YangD5014/PETA-CUSTOM/docs/img/kicad-render-node.png

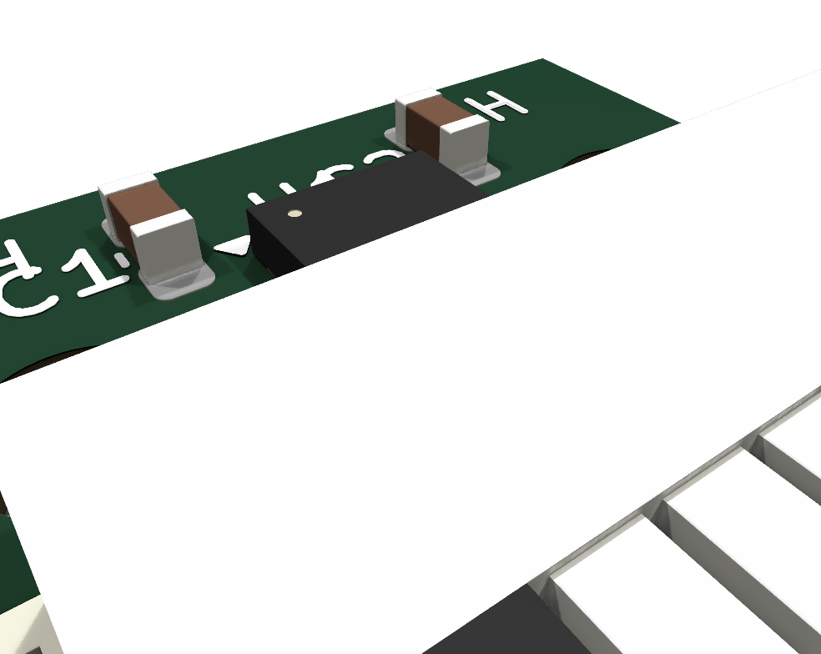
docs/img/kicad-render-node.png
