YangD5014/PETA-CUSTOM/docs/img/routed-board.png

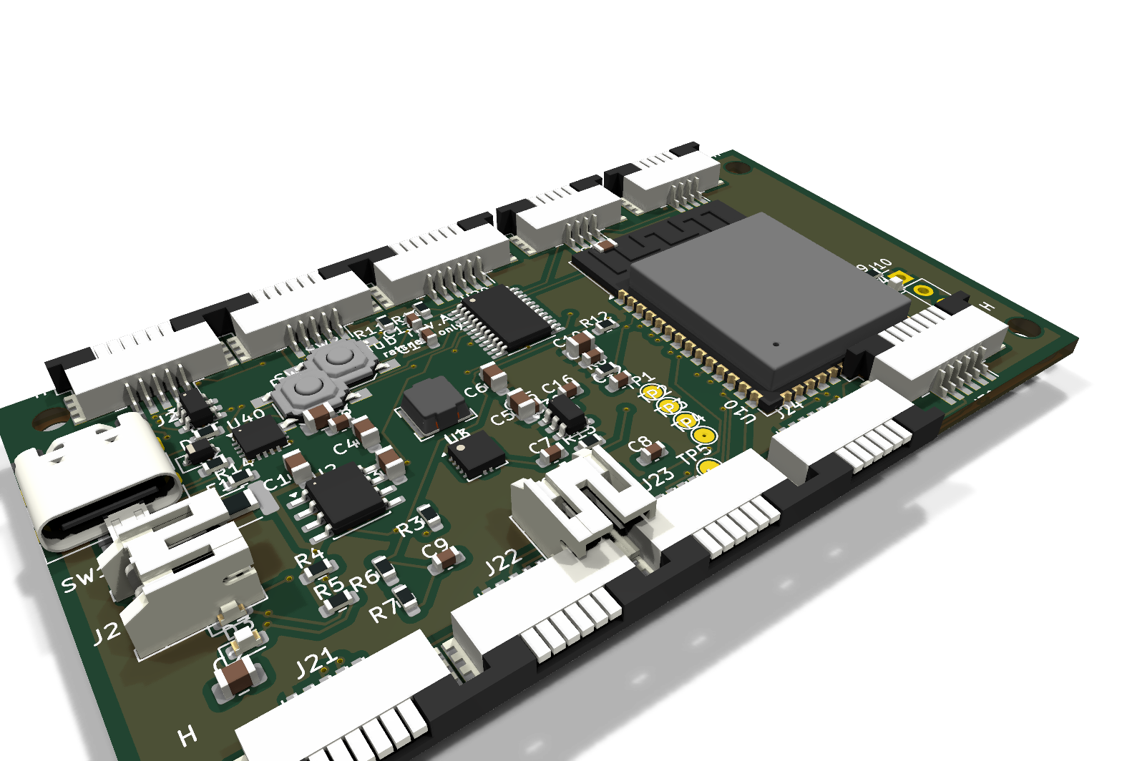
docs/img/routed-board.png
