YangD5014/PETA-CUSTOM/kicad/petvest-hub/preview/3d-bottom.png

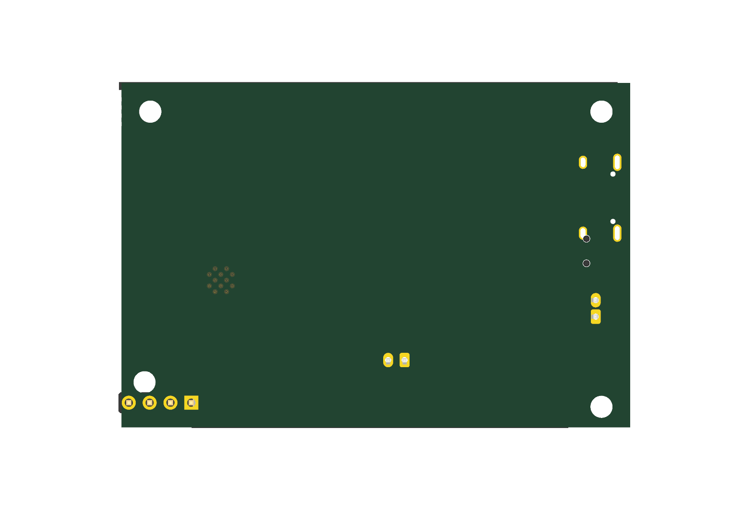
kicad/petvest-hub/preview/3d-bottom.png
