YangD5014/PETA-CUSTOM/3d/petvest-hub-外壳底壳.stl

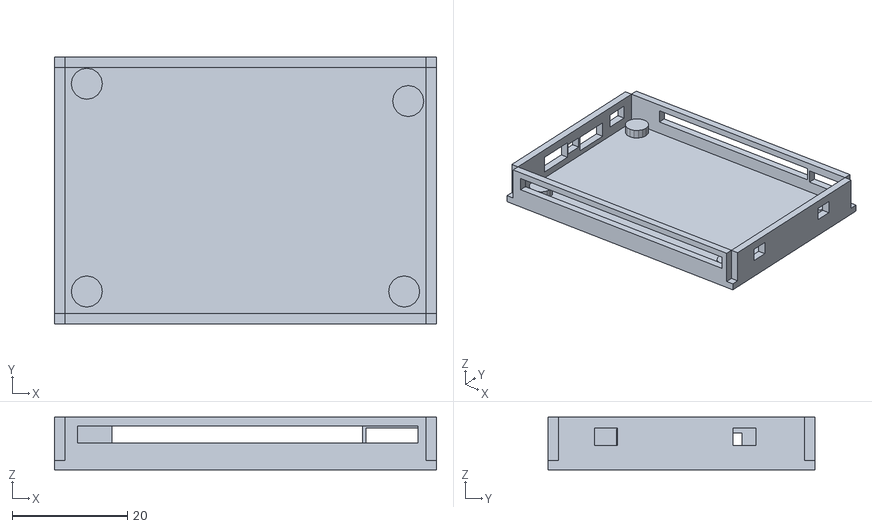
[picture p12: CAD file, 2026-11-07]
3d/petvest-hub-外壳底壳.stl
66.2 x 46.2 x 9.10
