YangD5014/PETA-CUSTOM/3d/petvest-hub.step

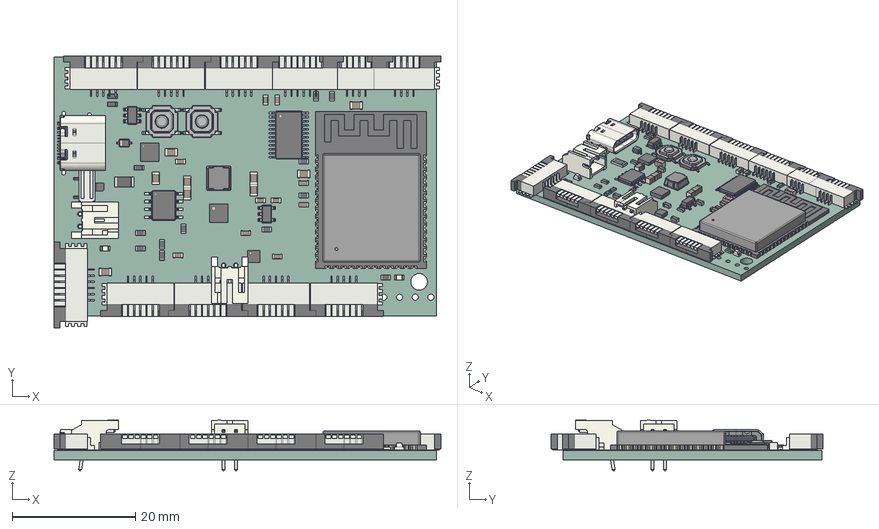
[picture p13: CAD file, 2026-11-07]
3d/petvest-hub.step
62.8 x 44.1 x 8.25 mm
USB_C_Receptacle_16P_TopMnt_Horizontal_GCT_USB4105-xx-A
Fusion_sp
JST_S2B_PH_K x 2
TE_84953_6 x 2
SOT-23-6
R_0603_1608Metric x 14
D_SOD-323
Fuse_1206_3216Metric
HSOP-8-1EP_3.9x4.9mm_P1.27mm_EP2.41x3.1mm
C_0805_2012Metric x 9
LED_0603_1608Metric x 3
VSON_10_1EP_3x3mm_Pitch05mm_ThermalPad
L_Bourns-SRN4018
C_0603_1608Metric x 10
DFN-8-1EP_2x2mm_Pitch0.5mm
QFN-16-1EP_3x3mm_P0.5mm_EP1.7x1.7mm
SOT-23-5
ESP32-S3-WROOM-1
SW_SPST_SKQG_WithStem x 2
TSSOP-24_4.4x7.8mm_P0.65mm
TE_84953_5 x 7
TE_84953_4 x 2
petvest-hub_PCB
