YangD5014/PETA-CUSTOM/3d/petvest-imu-node.step

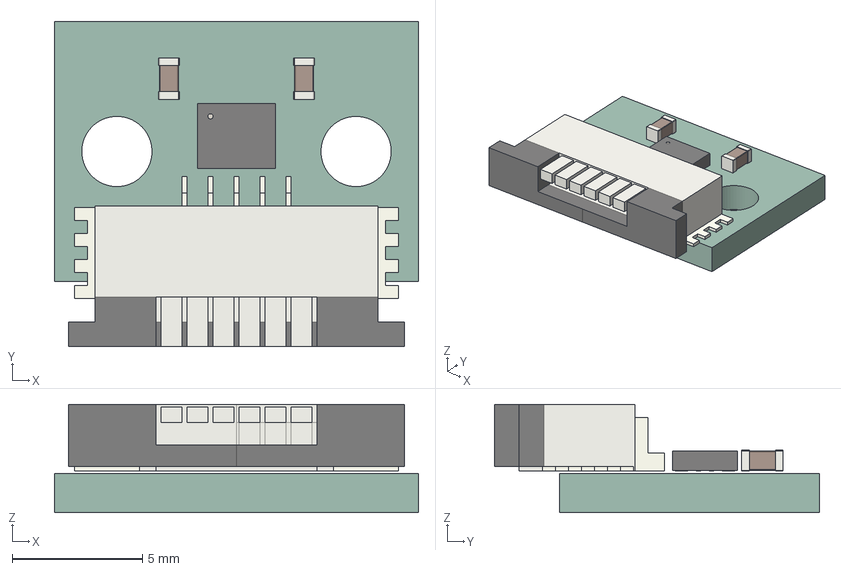
[picture p14: CAD file, 2026-11-07]
3d/petvest-imu-node.step
14.0 x 12.5 x 4.16 mm
LGA_14_3x25mm_P05mm_LayoutBorder3x4y
C_0603_1608Metric x 2
TE_84953_5
petvest-imu-node_PCB
