YangD5014/PETA-CUSTOM/3d/petvest-hub-外壳盖板.stl

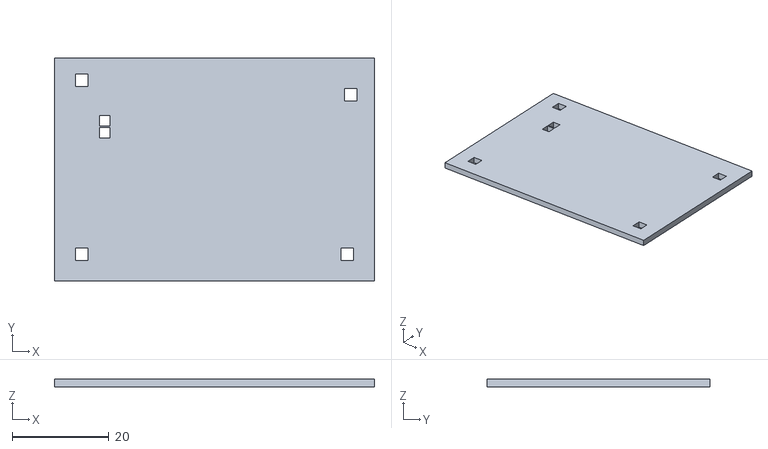
[picture p15: CAD file, 2026-11-07]
3d/petvest-hub-外壳盖板.stl
66.2 x 46.2 x 1.60
