YangD5014/PETA-CUSTOM/docs/petvest-hub-schematic.pdf

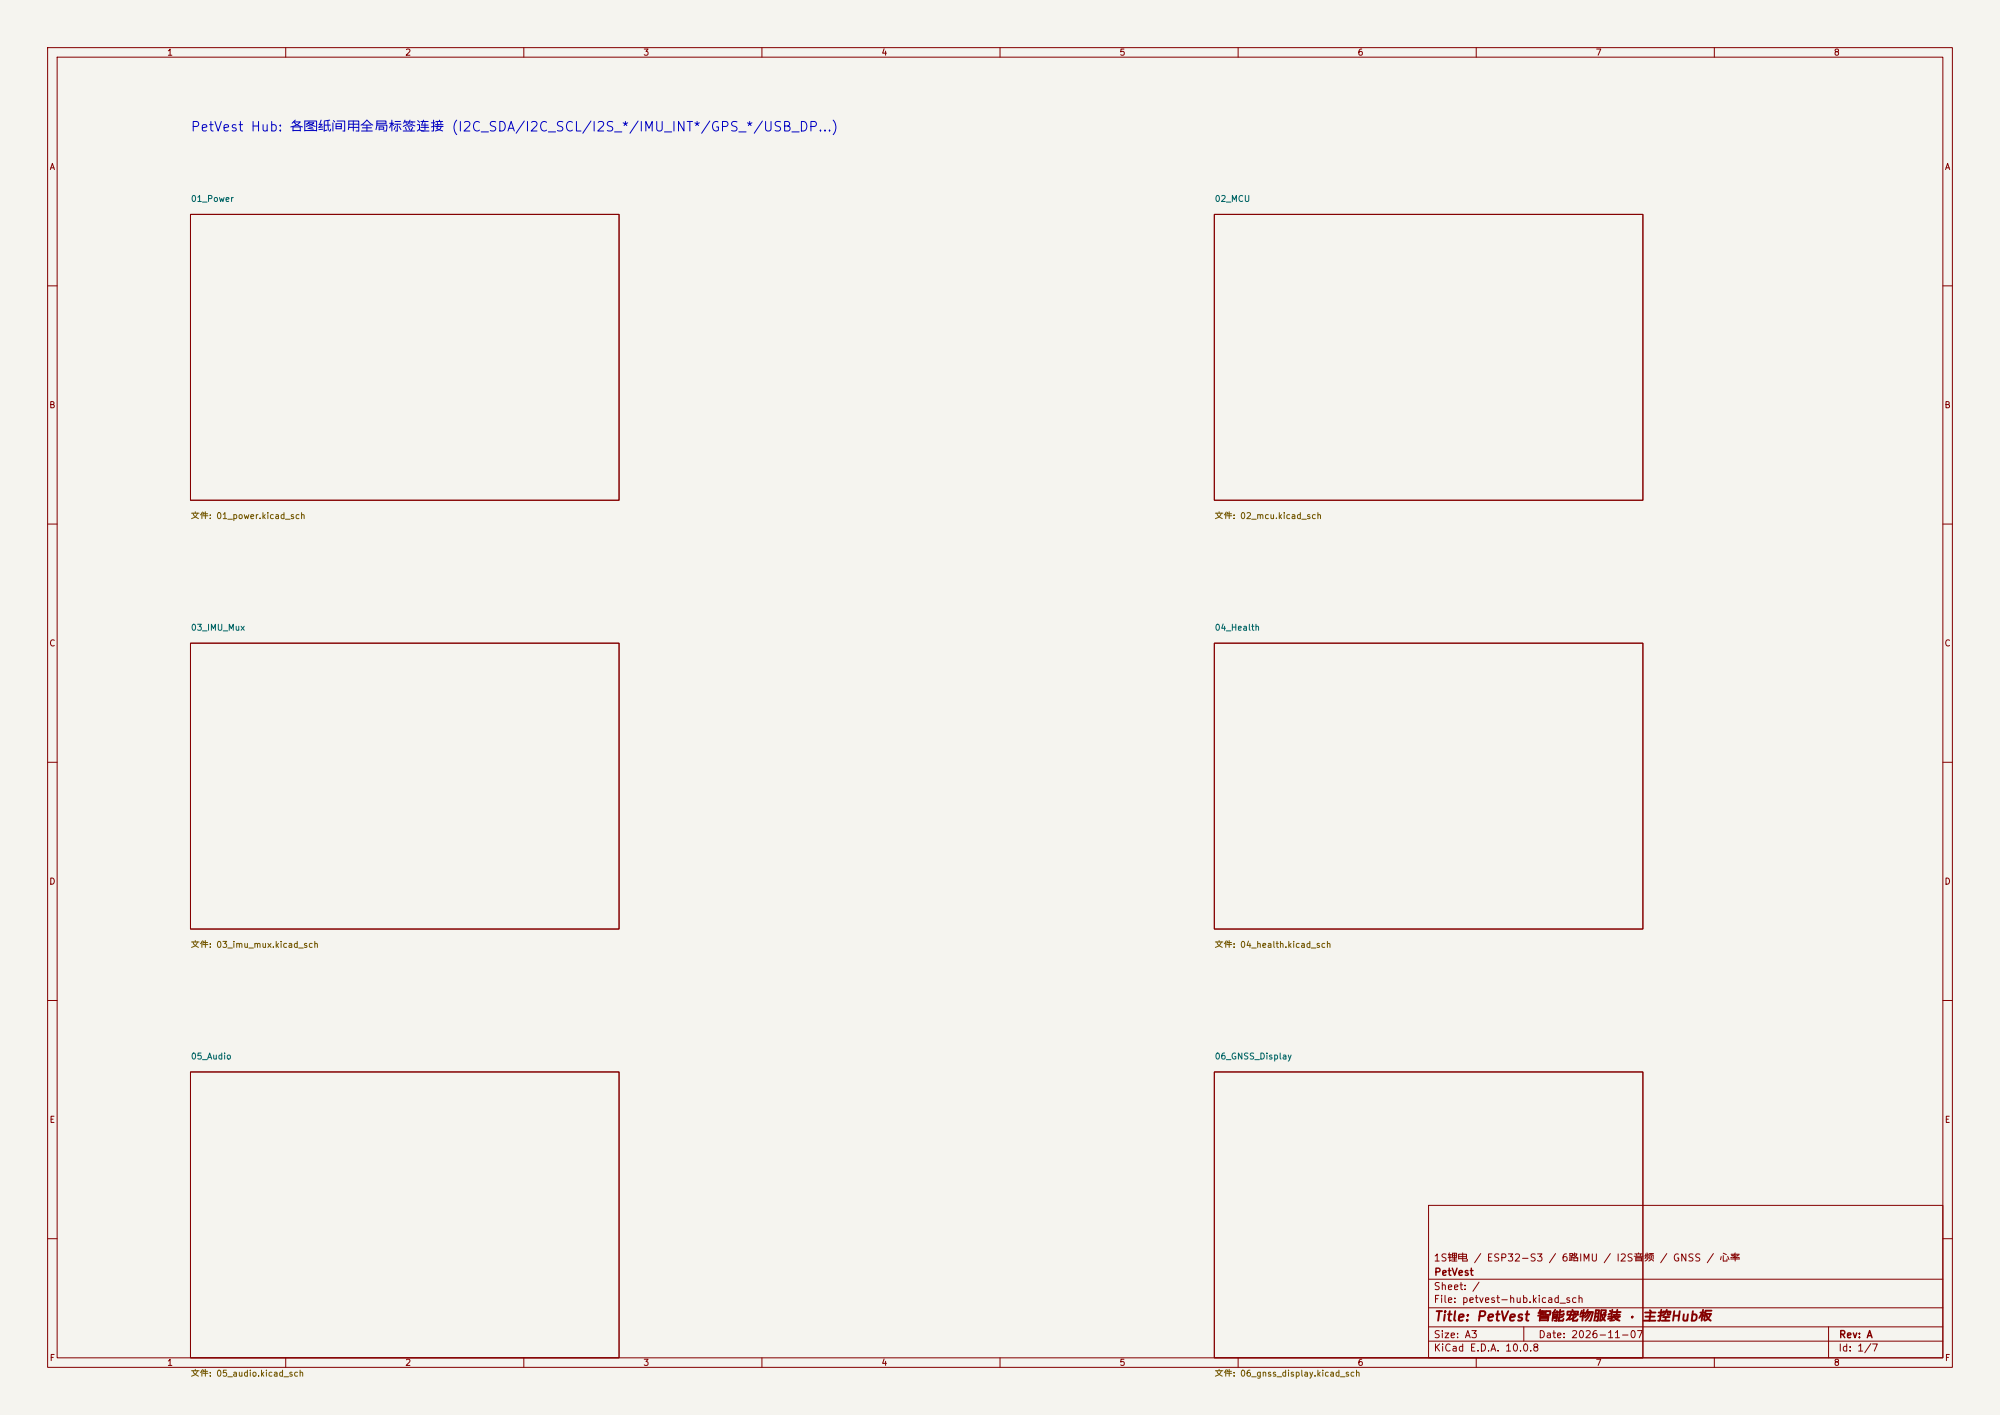
[picture p16: page 1]

1S锂电 / ESP32-S3 / 6路IMU / I2S音频 / GNSS / 心率 PetVest

Sheet: / File: petvest-hub.kicad_sch
Title: PetVest 智能宠物服装 · 主控Hub板

Size: A3 | Rev: A | F Date: 2026-11-07
KiCad E.D.A. 10.0.8 | Id: 1/7

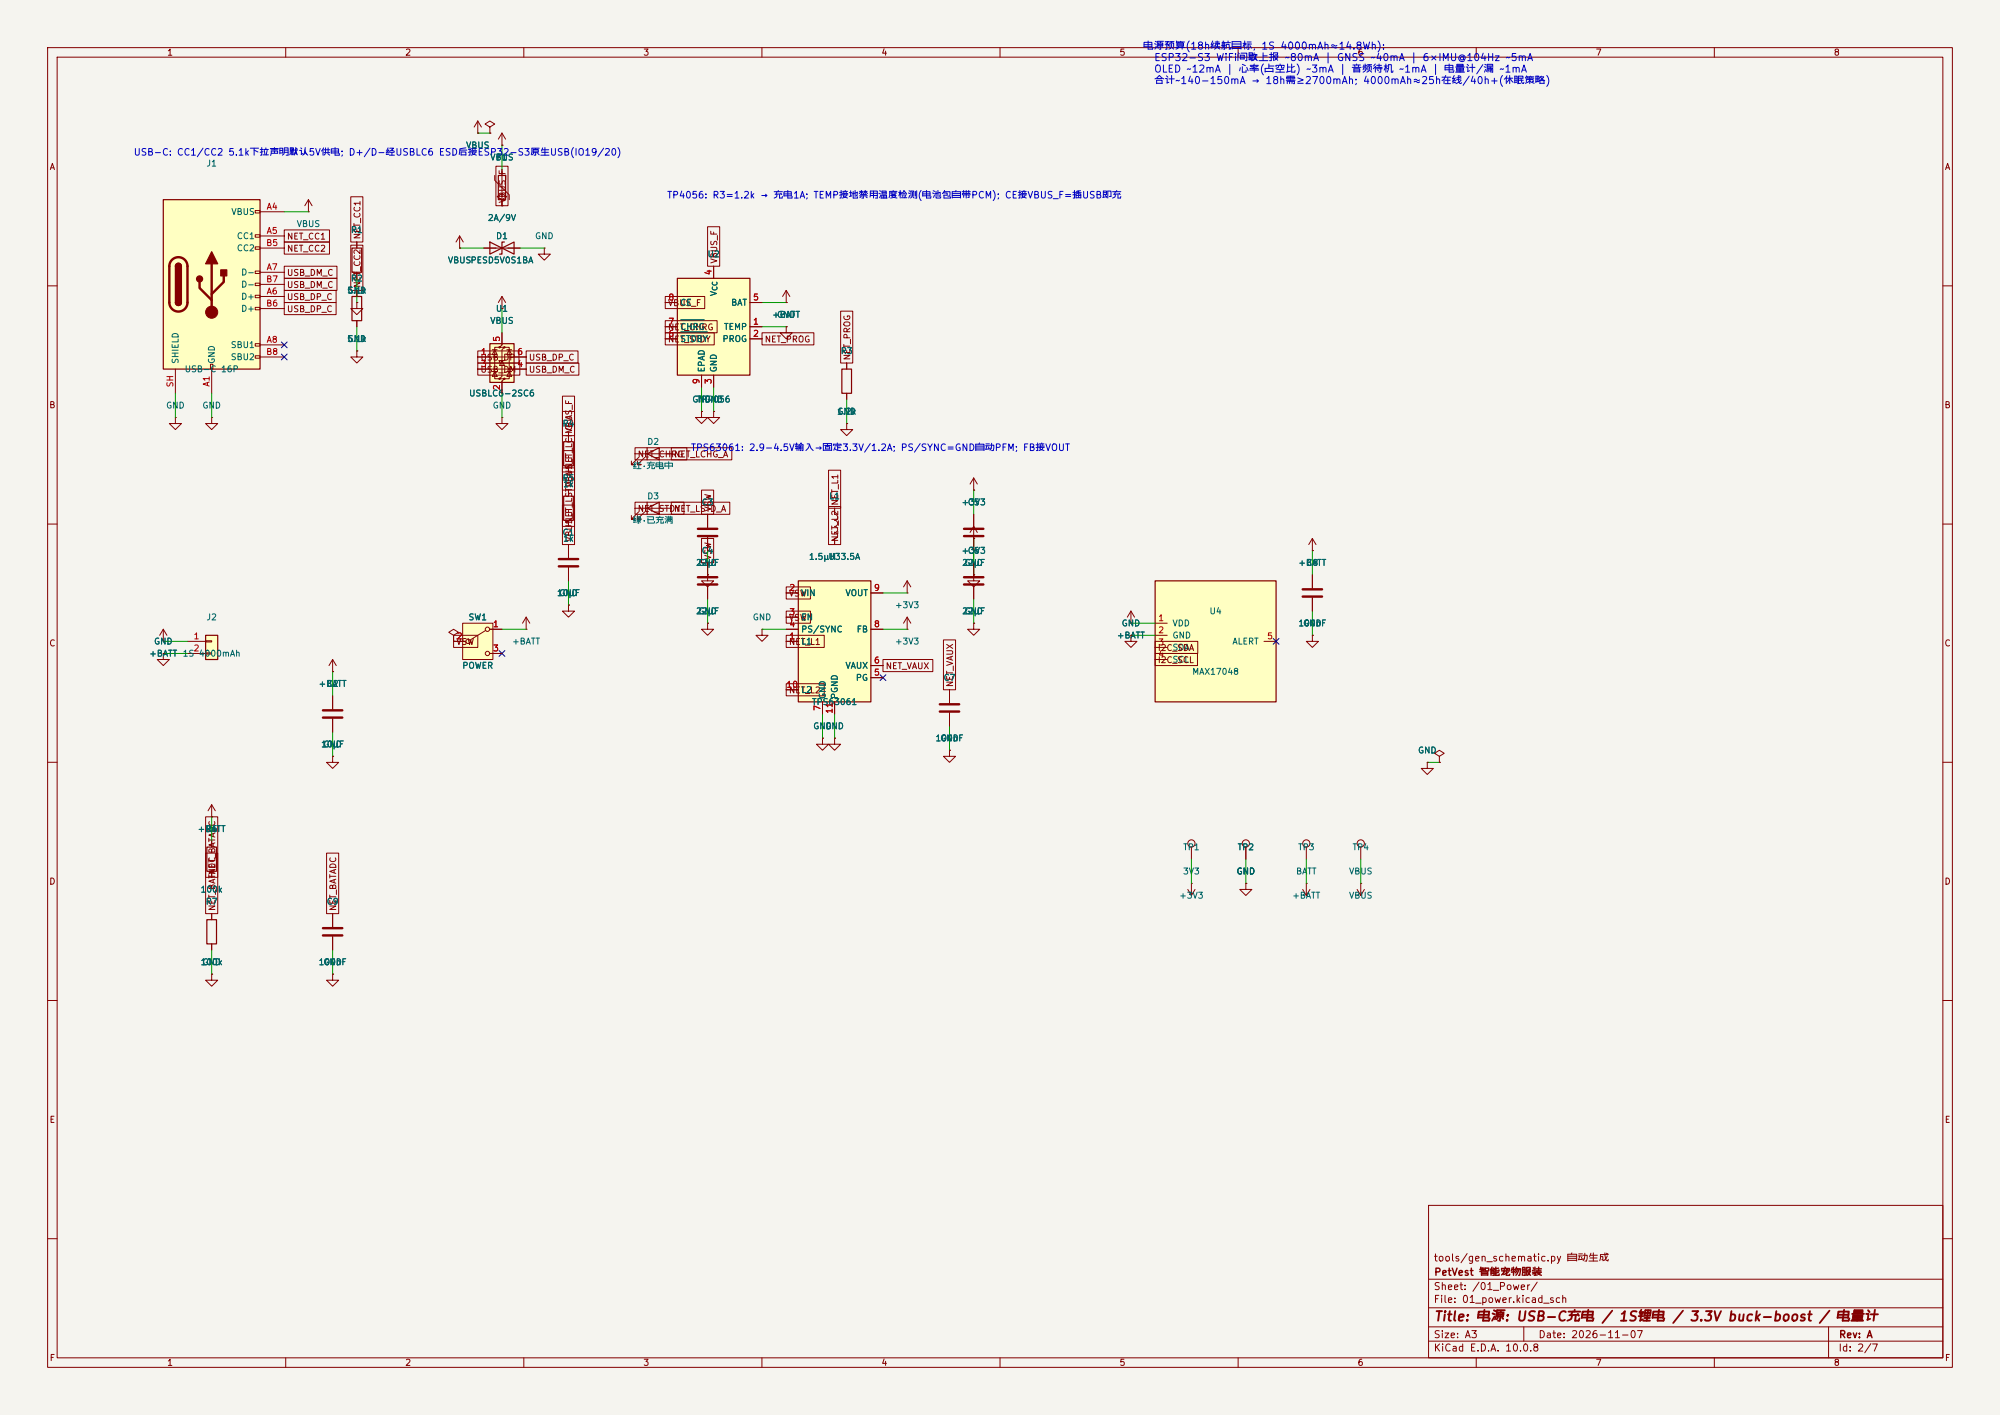
[picture p17: page 2]

电源预算(18h续航目标, 1S 4000mAh≈14.8Wh):
ESP32-S3 WiFi间歇上报 ~80mA | GNSS ~40mA | 6×IMU@104Hz ~5mA
OLED ~12mA | 心率(占空比) ~3mA | 音频待机 ~1mA | 电量计/漏 ~1mA

TPS63061: 2.9-4.5V输入→固定3.3V/1.2A; PS/SYNC=GND自动PFM; FB接VOUT USB-C: CC1/CC2 5.1k下拉声明默认5V供电; D+/D-经USBLC6 ESD后接ESP32-S3原生USB(IO19/20)
J1 USB-C 16P

tools/gen_schematic.py 自动生成
PetVest 智能宠物服装
Sheet: /01_Power/
File: 01_power.kicad_sch
Title: 电源: USB-C充电 / 1S锂电 / 3.3V buck-boost / 电量计

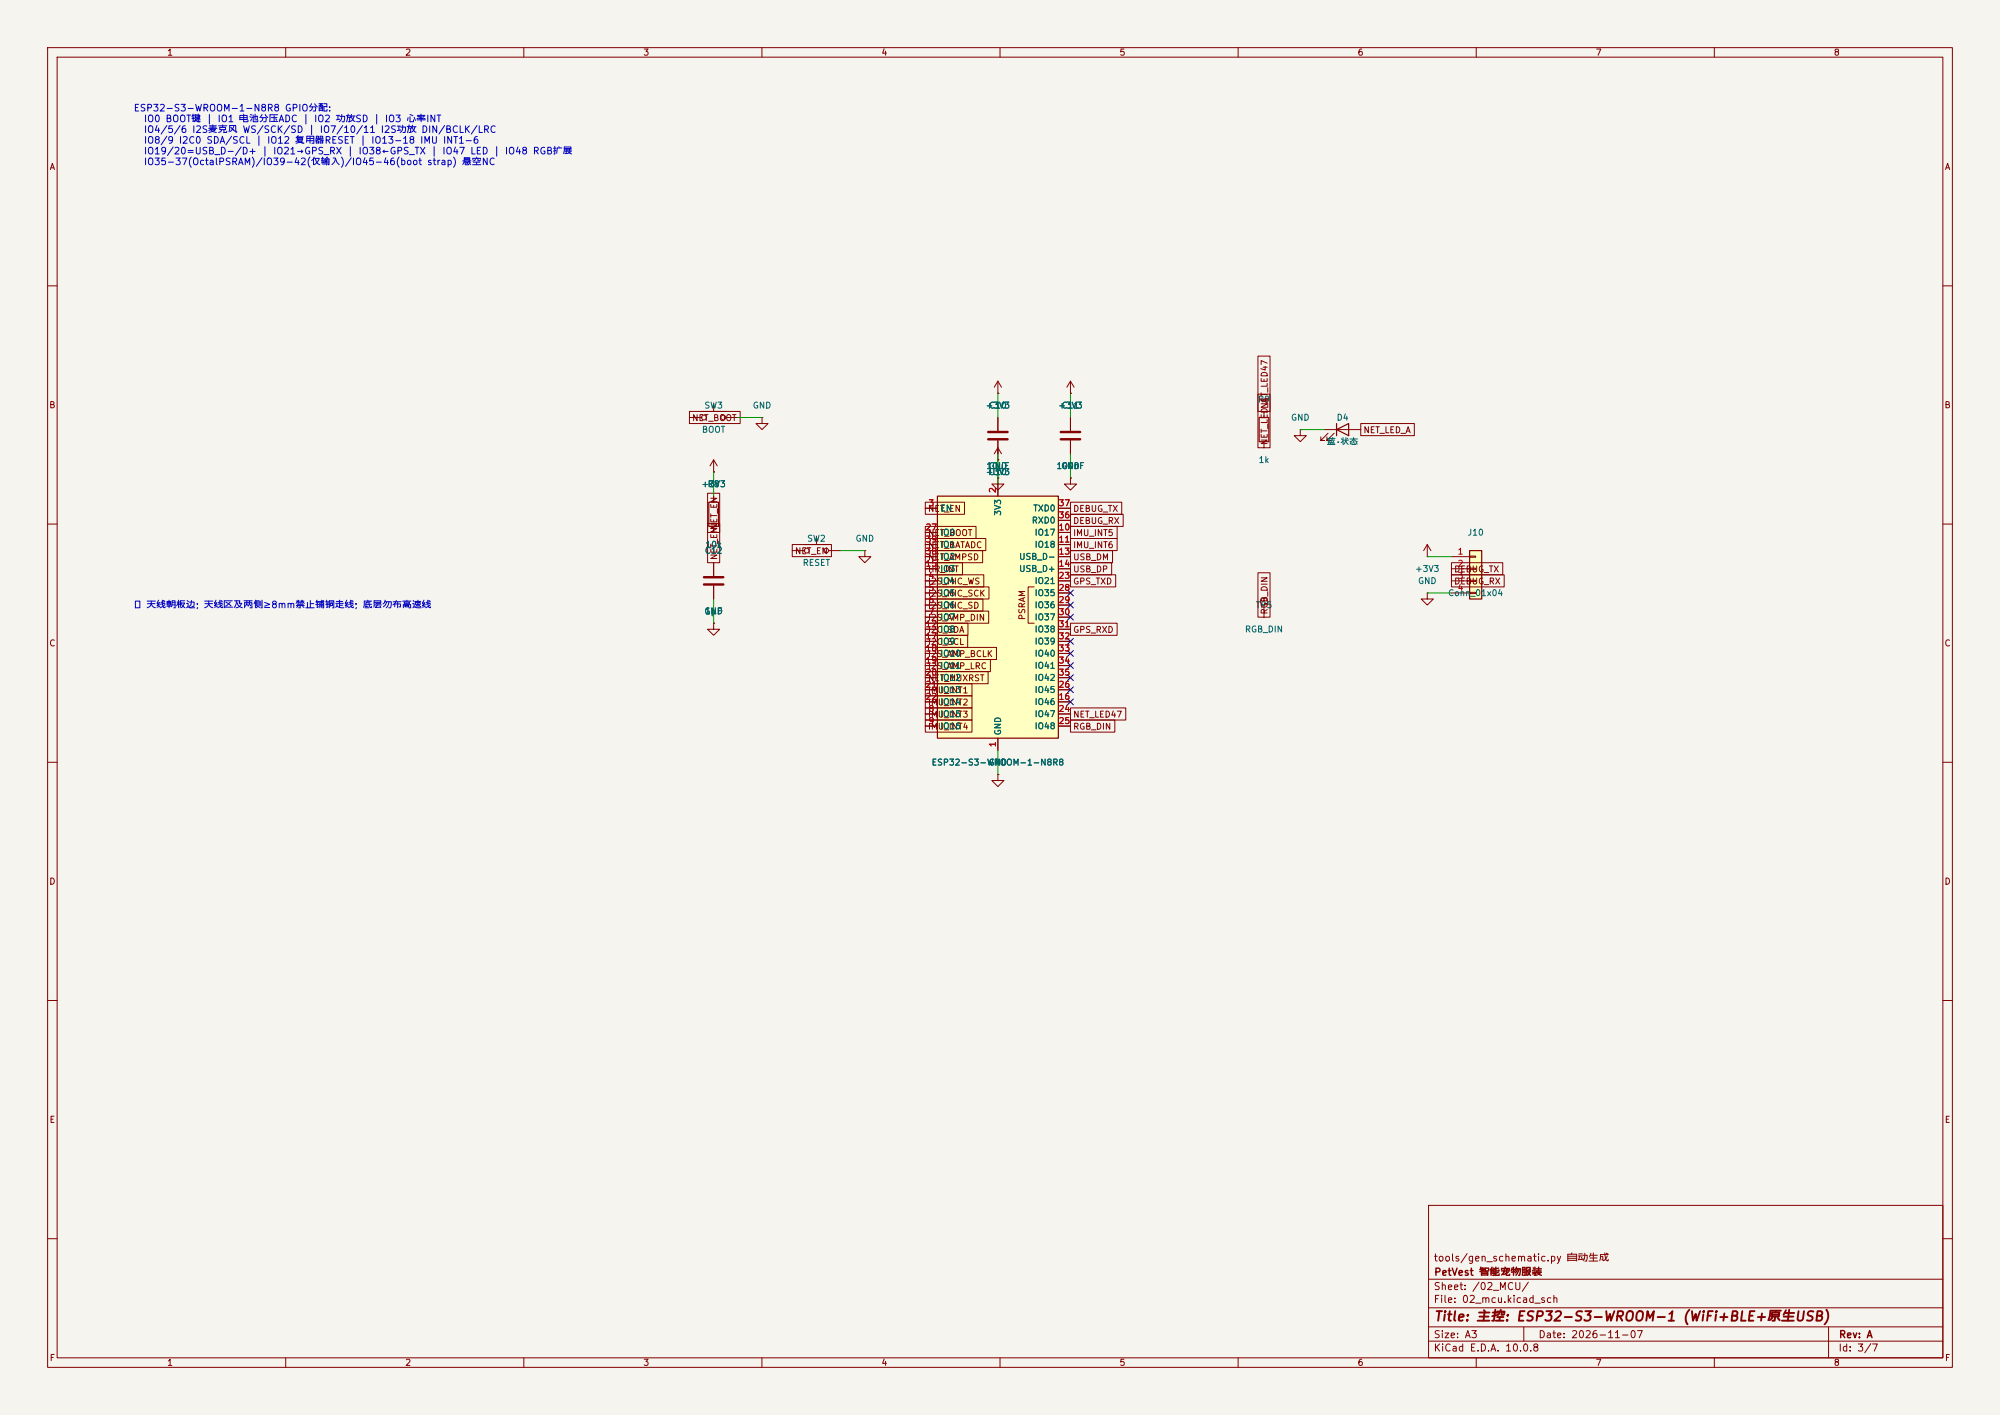
[picture p18: page 3]

ESP32-S3-WROOM-1-N8R8 GPIO分配:
IO0 BOOT键 | IO1 电池分压ADC | IO2 功放SD | IO3 心率INT
IO4/5/6 I2S麦克风 WS/SCK/SD | IO7/10/11 I2S功放 DIN/BCLK/LRC
IO8/9 I2C0 SDA/SCL | IO12 复用器RESET | IO13-18 IMU INT1-6
IO19/20=USB_D-/D+ | IO21→GPS_RX | IO38←GPS_TX | IO47 LED | IO48 RGB扩展
IO35-37(OctalPSRAM)/IO39-42(仅输入)/IO45-46(boot strap) 悬空NC ⚠ 天线朝板边; 天线区及两侧≥8mm禁止铺铜走线; 底层勿布高速线

tools/gen_schematic.py 自动生成
PetVest 智能宠物服装
Sheet: /02_MCU/
File: 02_mcu.kicad_sch
Title: 主控: ESP32-S3-WROOM-1 (WiFi+BLE+原生USB)

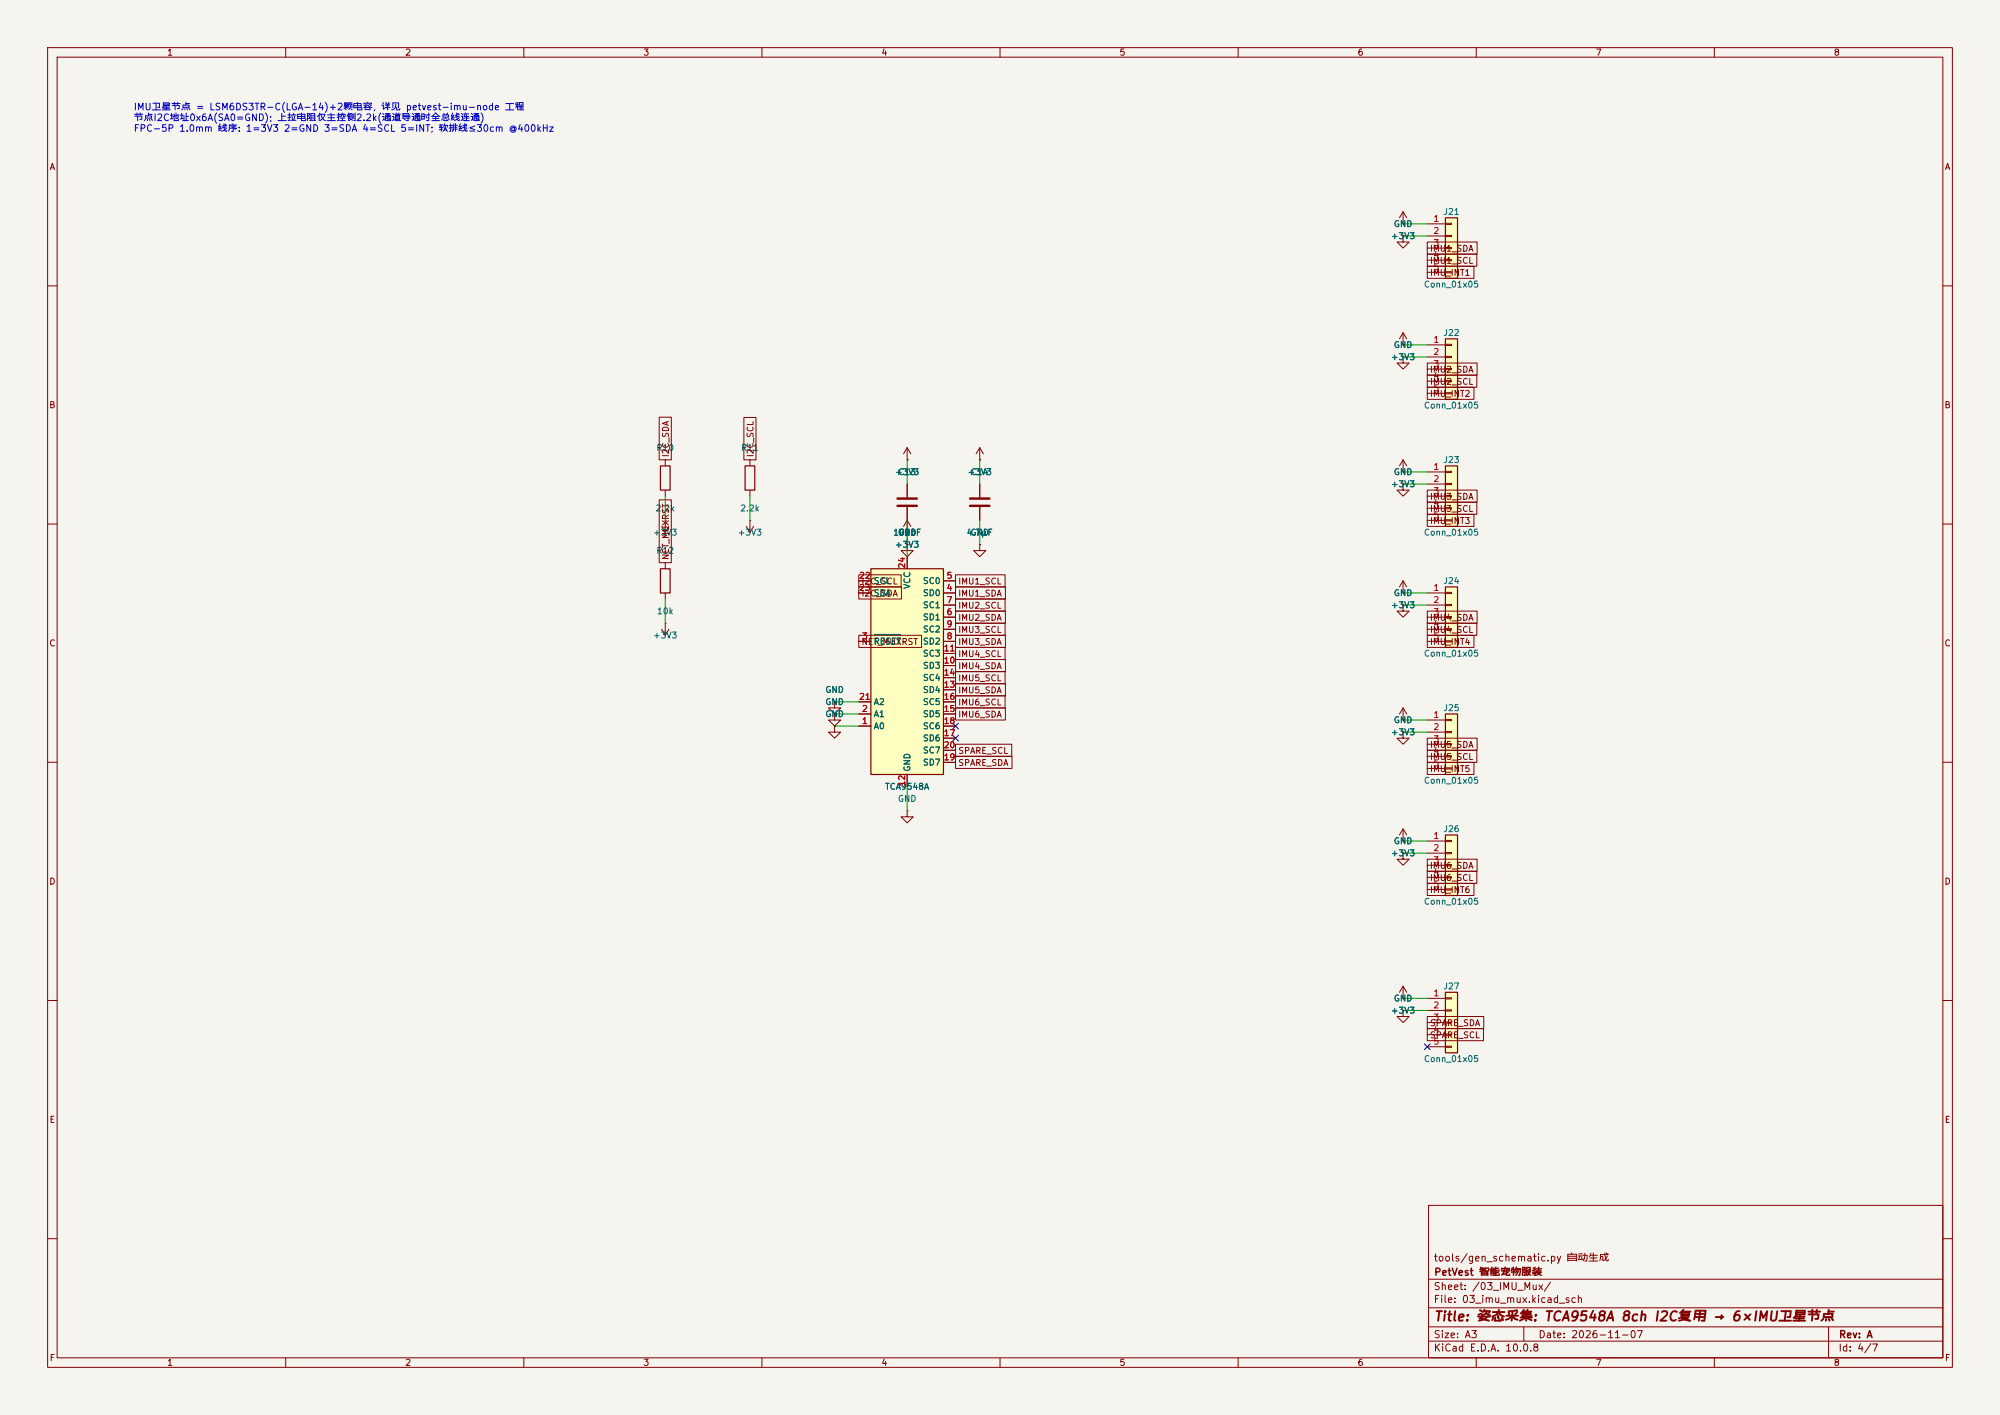
[picture p19: page 4]

IMU卫星节点 = LSM6DS3TR-C(LGA-14)+2颗电容, 详见 petvest-imu-node 工程

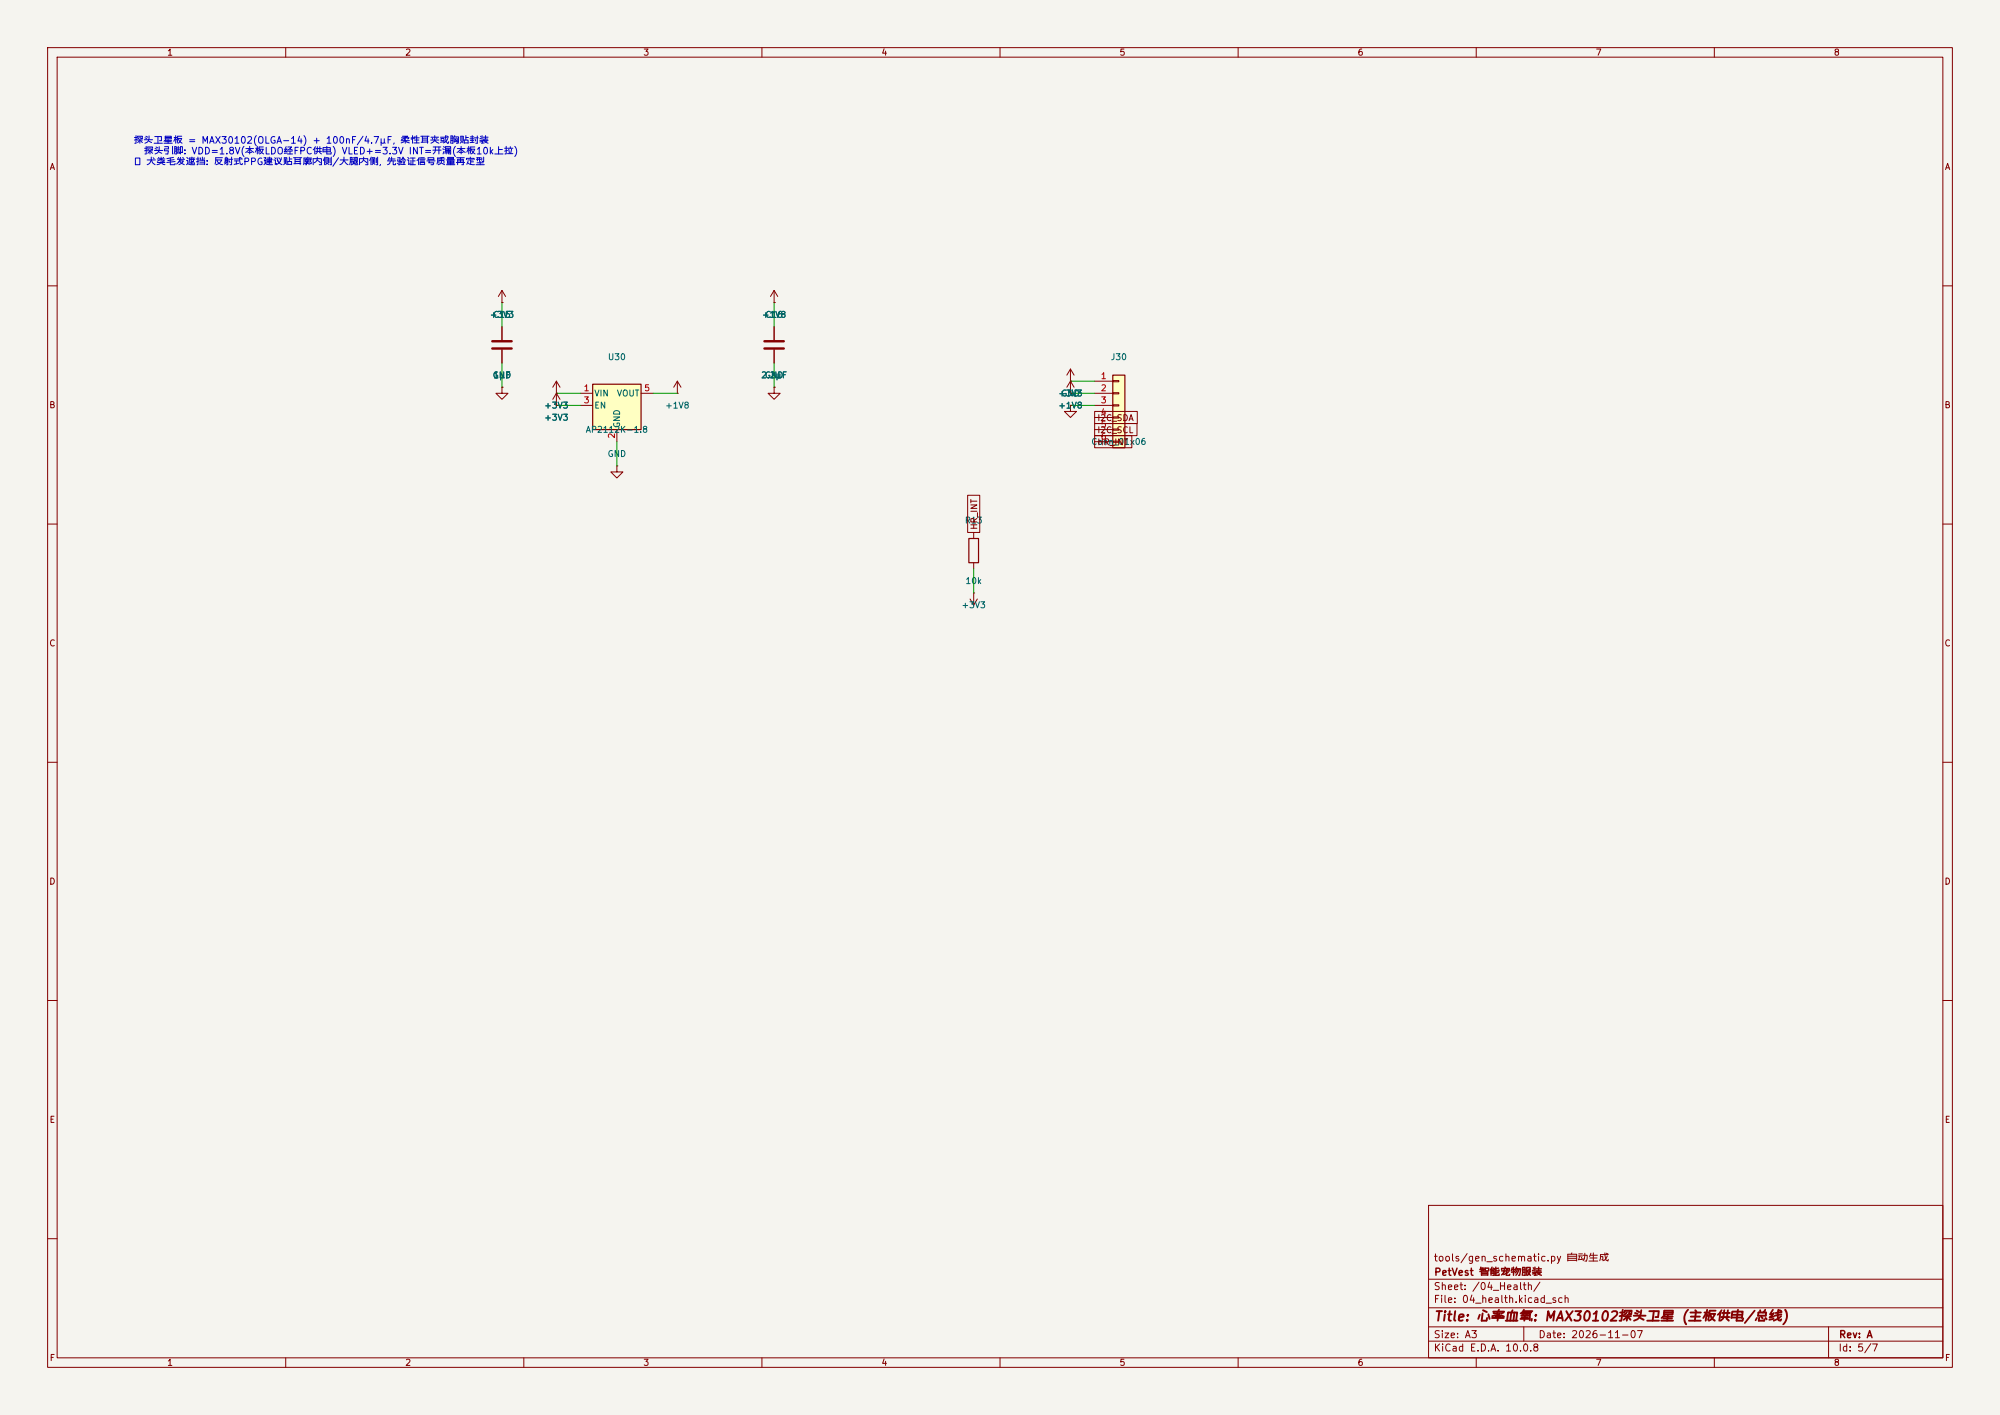
[picture p20: page 5]

I2C_SDA 探头卫星板 = MAX30102(OLGA-14) + 100nF/4.7µF, 柔性耳夹或胸贴封装
探头引脚: VDD=1.8V(本板LDO经FPC供电) VLED+=3.3V INT=开漏(本板10k上拉) ⚠ 犬类毛发遮挡: 反射式PPG建议贴耳廓内侧/大腿内侧, 先验证信号质量再定型

tools/gen_schematic.py 自动生成
PetVest 智能宠物服装
Sheet: /04_Health/
File: 04_health.kicad_sch
Title: 心率血氧: MAX30102探头卫星 (主板供电/总线)

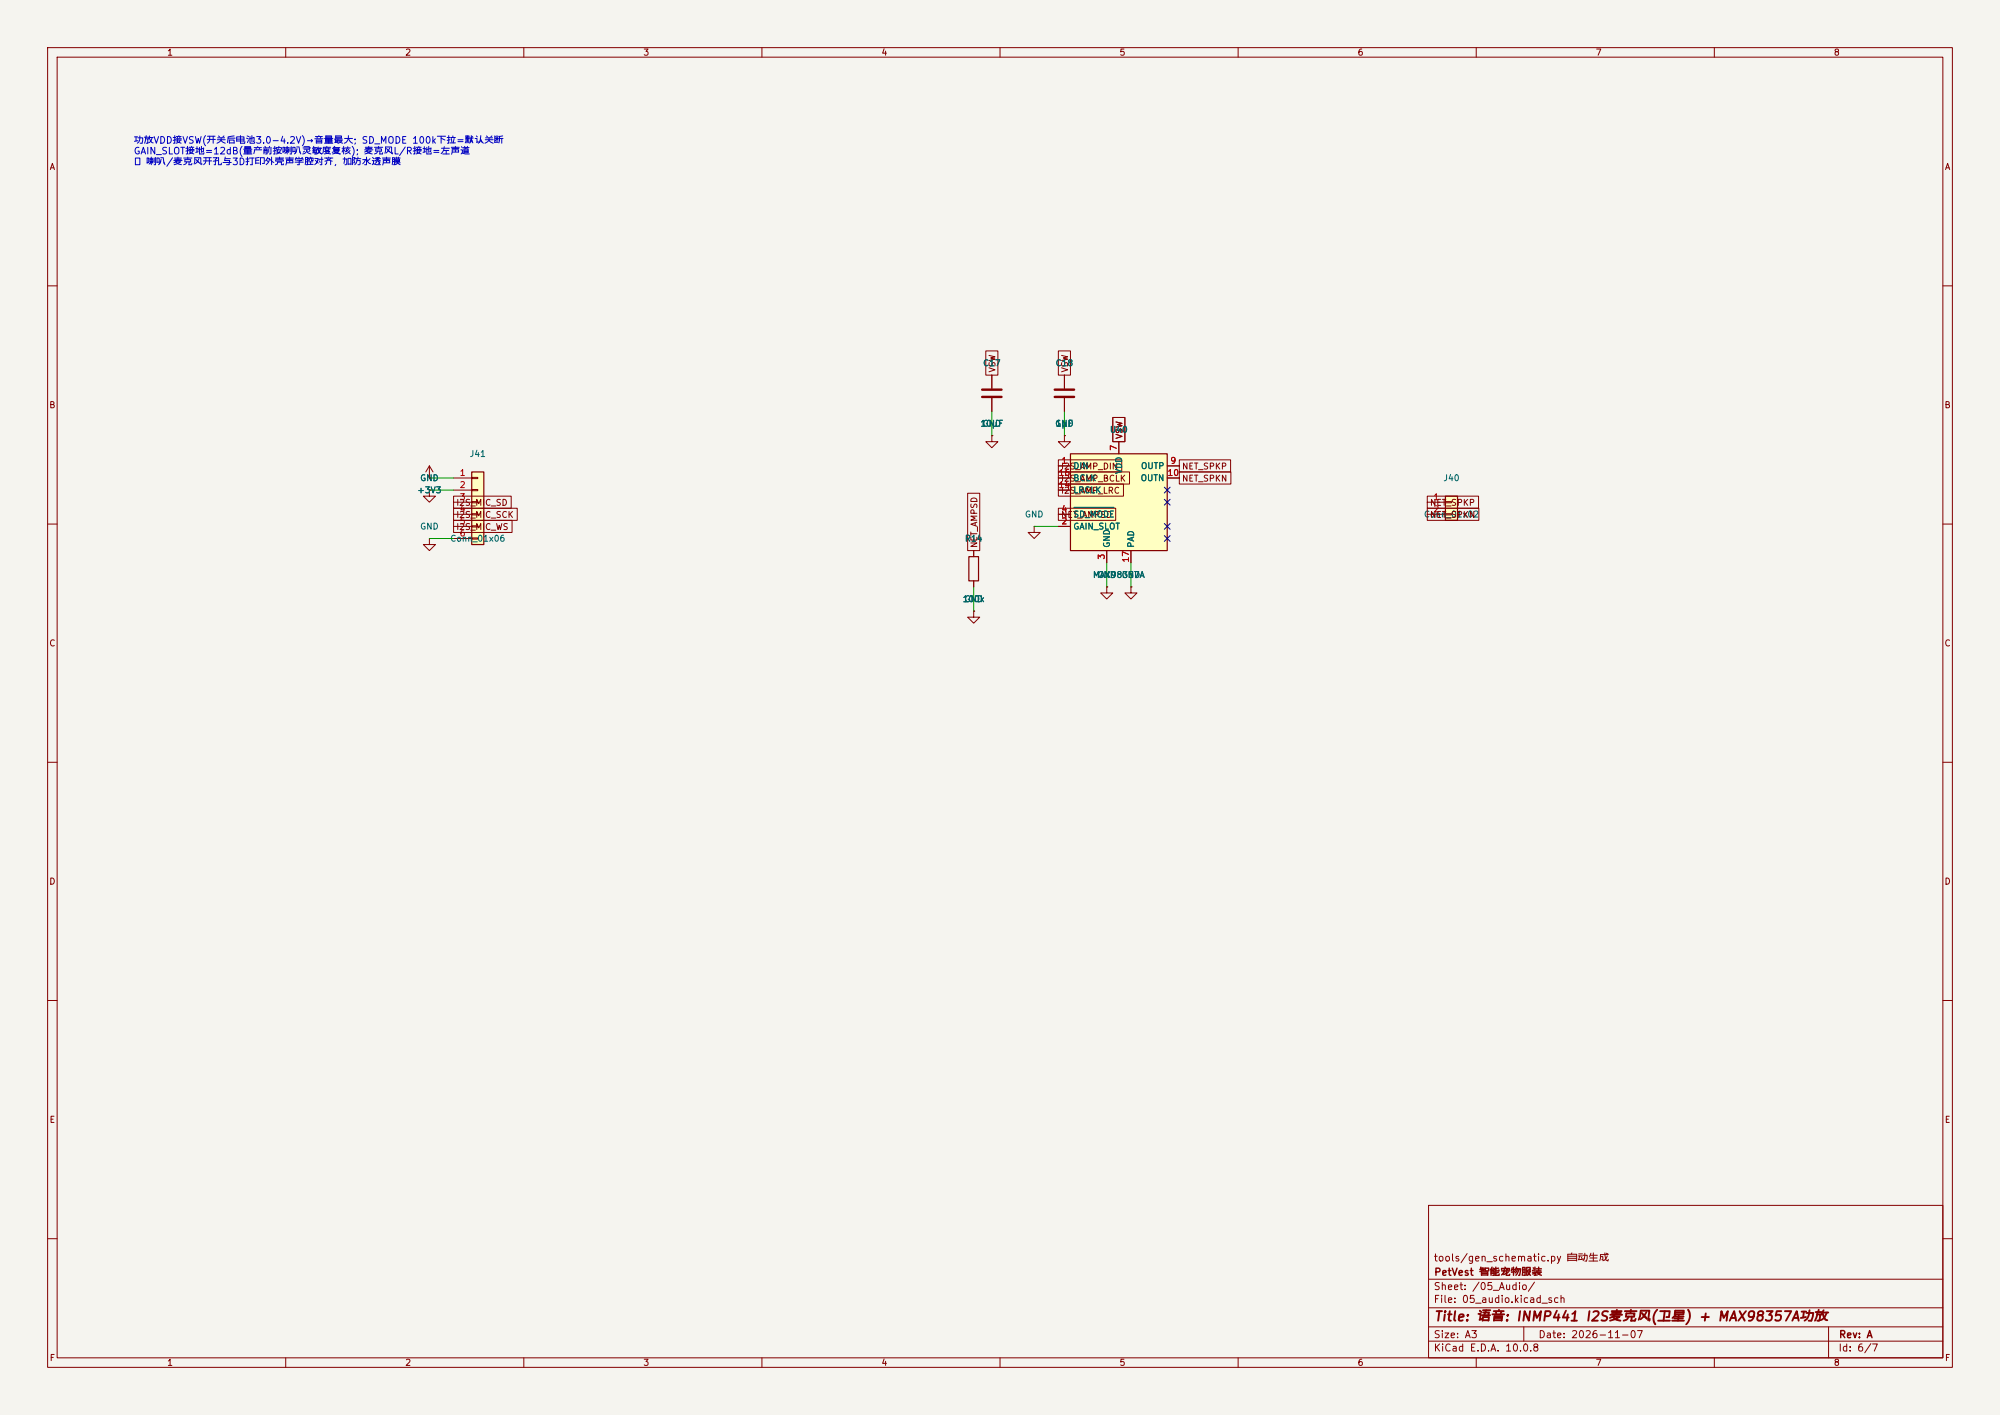
[picture p21: page 6]

GAIN_SLOT接地=12dB(量产前按喇叭灵敏度复核); 麦克风L/R接地=左声道
⚠ 喇叭/麦克风开孔与3D打印外壳声学腔对齐, 加防水透声膜

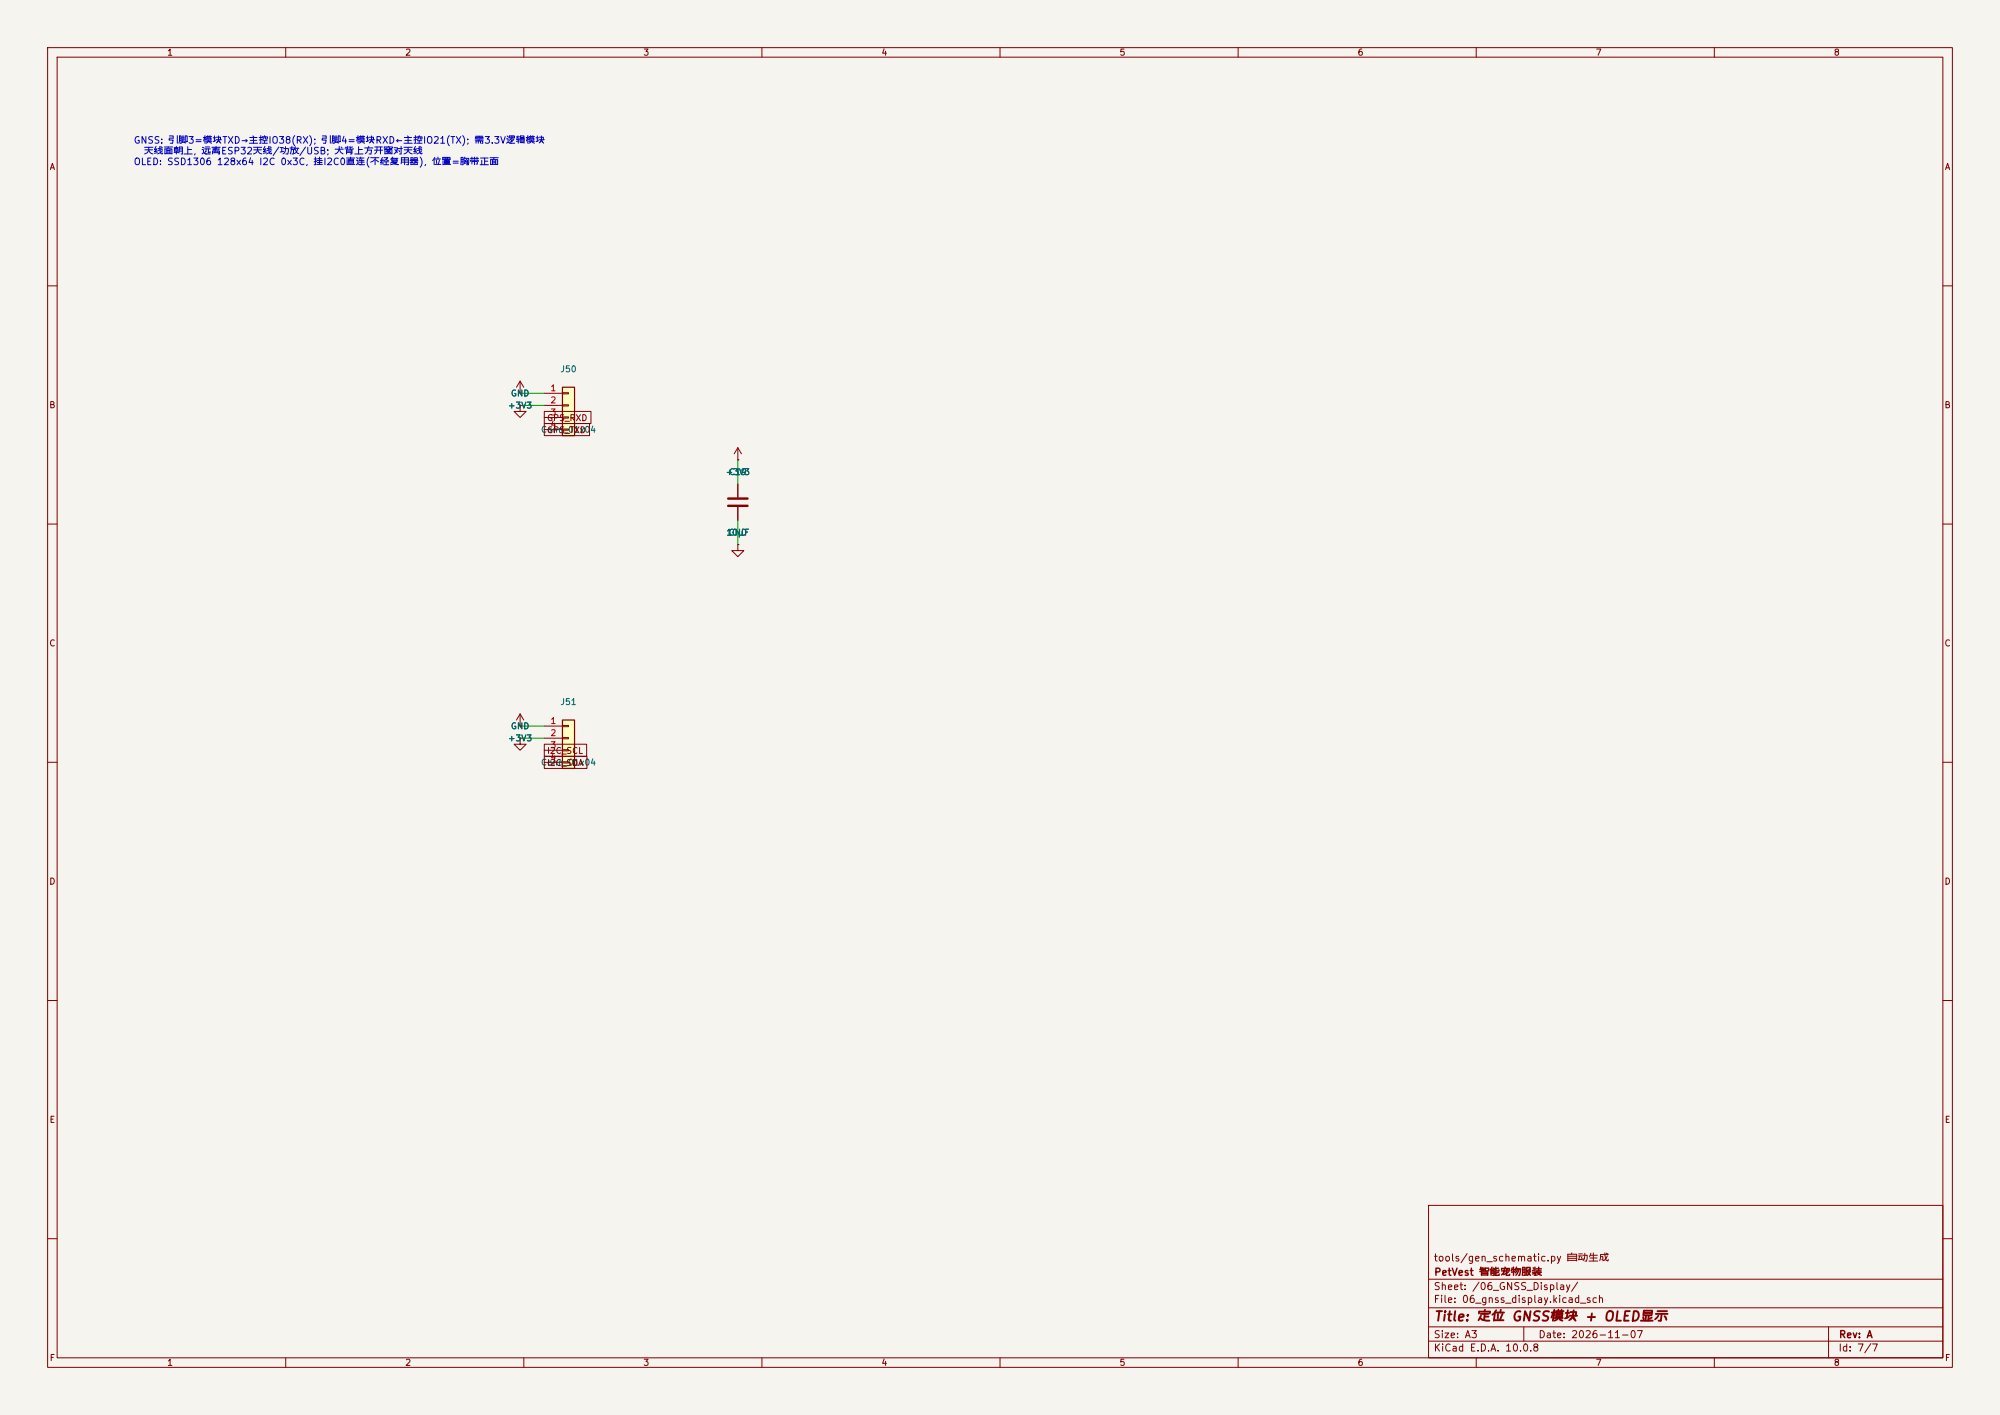
[picture p22: page 7]

GPS_TXD GNSS: 引脚3=模块TXD→主控IO38(RX); 引脚4=模块RXD←主控IO21(TX); 需3.3V逻辑模块
天线面朝上, 远离ESP32天线/功放/USB; 犬背上方开窗对天线
OLED: SSD1306 128x64 I2C 0x3C, 挂I2C0直连(不经复用器), 位置=胸带正面

tools/gen_schematic.py 自动生成
PetVest 智能宠物服装
Sheet: /06_GNSS_Display/
File: 06_gnss_display.kicad_sch
Title: 定位 GNSS模块 + OLED显示
