YangD5014/PETA-CUSTOM/docs/petvest-imu-node-schematic.pdf

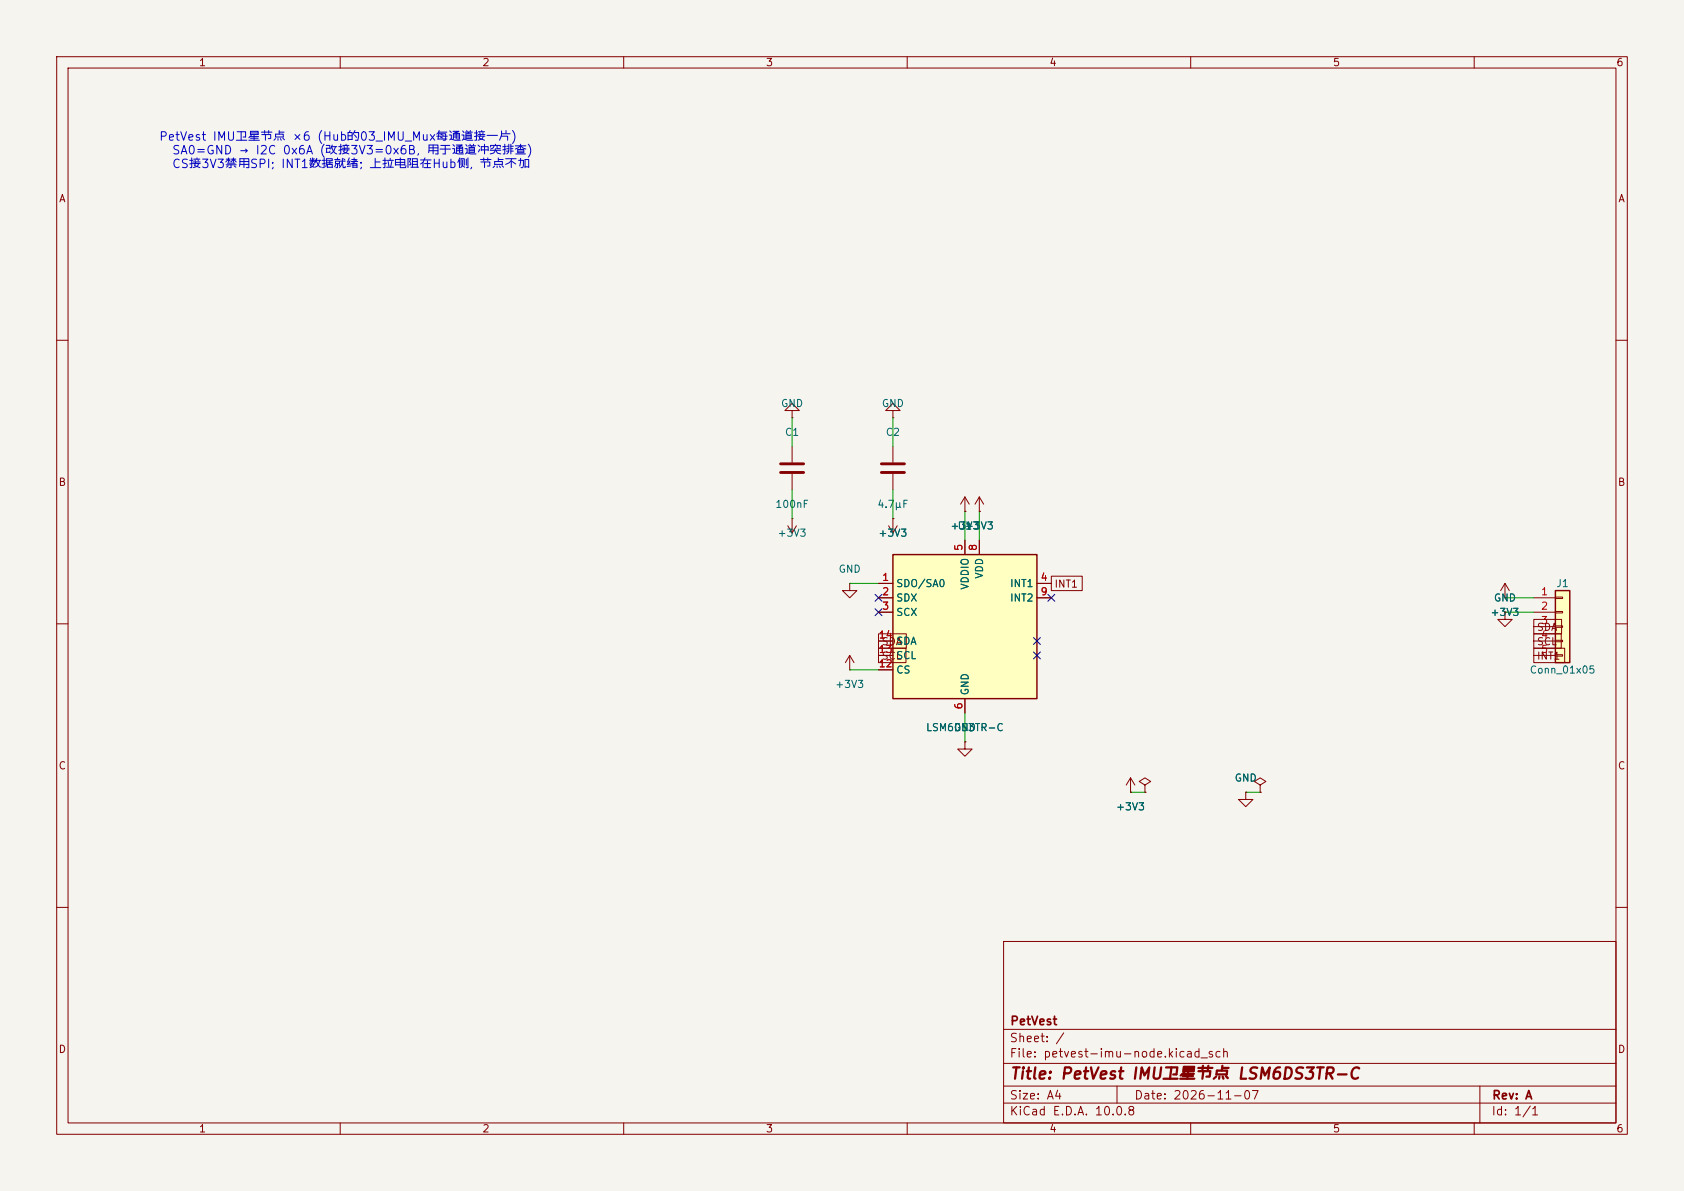
[picture p23: page 1]

INT1 PetVest IMU卫星节点 ×6 (Hub的03_IMU_Mux每通道接一片)
SA0=GND → I2C 0x6A (改接3V3=0x6B, 用于通道冲突排查) CS接3V3禁用SPI; INT1数据就绪; 上拉电阻在Hub侧, 节点不加

Sheet: /
File: petvest-imu-node.kicad_sch
Title: PetVest IMU卫星节点 LSM6DS3TR-C

Size: A4 | Rev: A
KiCad E.D.A. 10.0.8 | Id: 1/1
