YangD5014/PETA-CUSTOM/(list of files, drawings)

Other design files:
kicad/petvest-hub/hub_v9.dsn
