YangD5014/PETA-CUSTOM/kicad/petvest-imu-node/petvest-imu-node.kicad_pcb

## KiCad design kicad/petvest-imu-node/petvest-imu-node.kicad_pcb (2026-11-10)

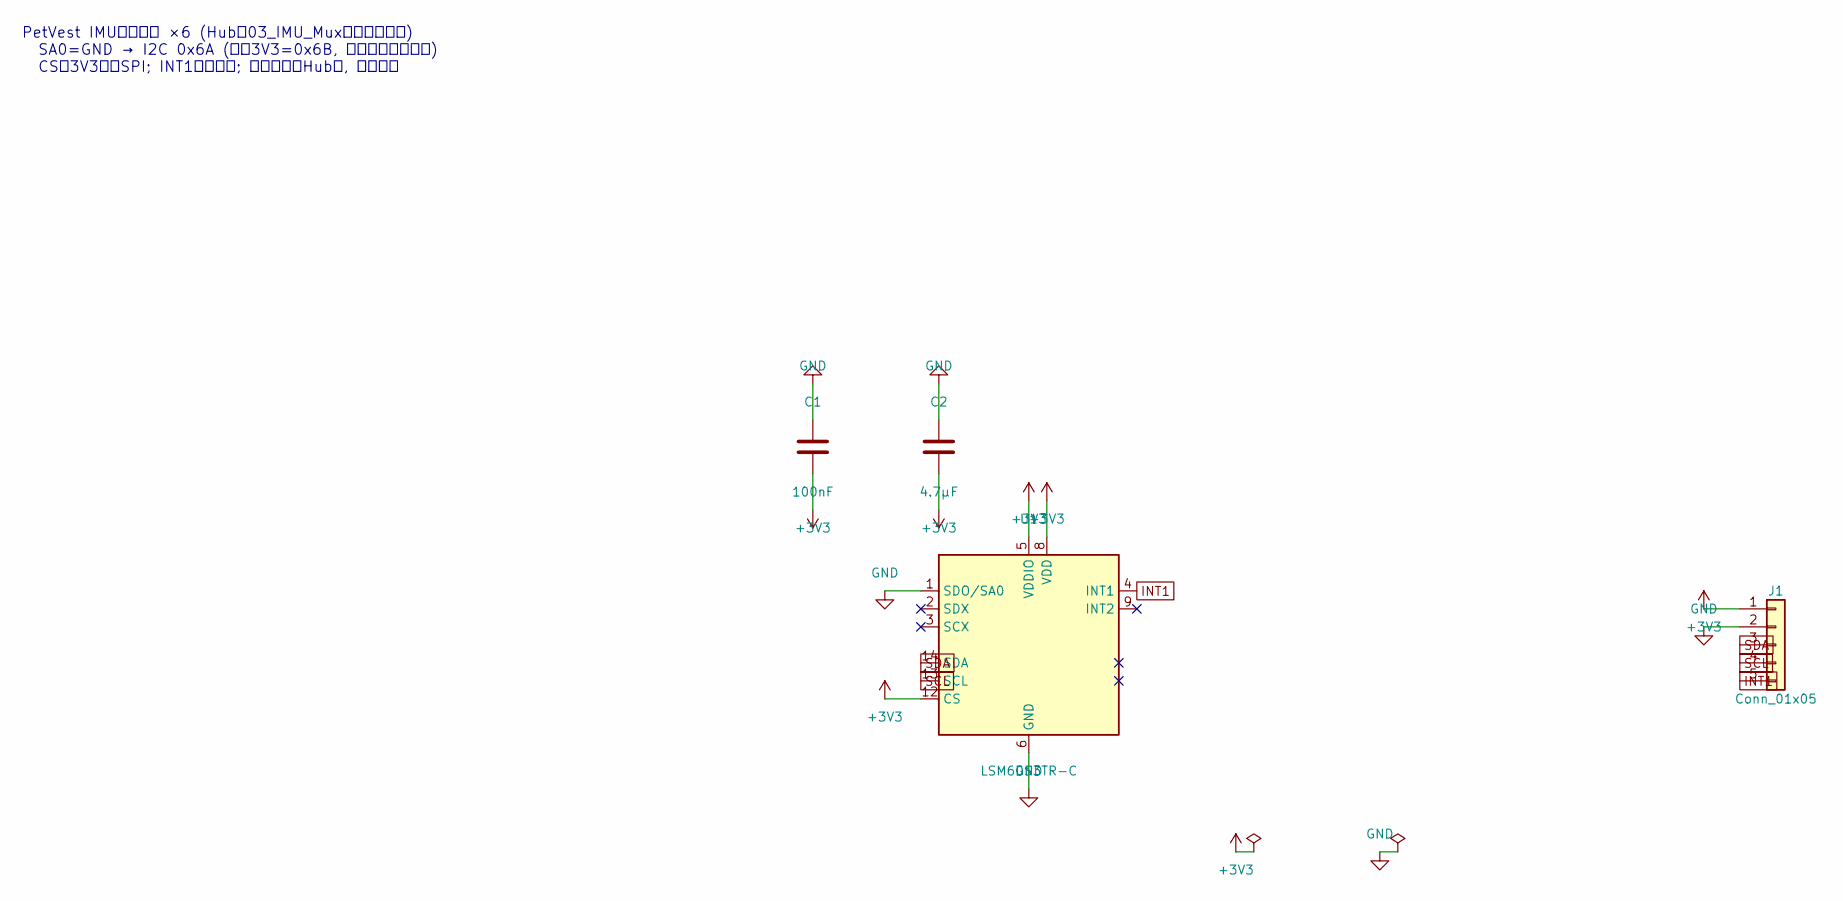
[picture p32: schematic petvest-imu-node.kicad_sch, PetVest IMU卫星节点 LSM6DS3TR-C]

Parts:
C1: 100nF; C_0603_1608Metric
C2: 4.7µF; C_0603_1608Metric
J1: Conn_01x05; TE_84953-5_1x05-1MP_P1.0mm_Horizontal
U1: LSM6DS3TR-C; LGA-14_3x2.5mm_P0.5mm_LayoutBorder3x4y

Connections:
+3V3: C1.2, C2.2, J1.1, U1.5 (VDDIO), U1.8 (VDD), U1.12 (CS)
GND: C1.1, C2.1, J1.2, U1.1 (SDO/SA0), U1.6 (GND), U1.7 (GND)
INT1: J1.5, U1.4 (INT1)
SCL: J1.4, U1.13 (SCL)
SDA: J1.3, U1.14 (SDA)

Notes on the sheet:
PetVest IMU卫星节点 ×6 (Hub的03_IMU_Mux每通道接一片) SA0=GND → I2C 0x6A (改接3V3=0x6B, 用于通道冲突排查) CS接3V3禁用SPI; INT1数据就绪; 上拉电阻在Hub侧, 节点不加

Board: 2 copper layers, 6 parts (0 on the bottom side), 5 nets, no tracks yet.

Other parts of the board:
H: MountingHole_2.7mm
H#2: MountingHole_2.7mm
