YangD5014/PETA-CUSTOM/(commit log)

2026-11-07 PETA CUSTOM v1.0: 多传感器宠物智能服装硬件方案 (KiCad 10)
    - 主控Hub板: ESP32-S3-WROOM-1 / 6路IMU(TCA9548A) / I2S语音 / GNSS / 心率 / OLED
    - 原理图 7 张分层图纸, 网表经 kicad-cli 交叉校验 PASS
    - PCB 62x42mm 70 封装布局; IMU 卫星节点 14x10mm x6
    - 3D: STEP/GLB + 3D打印外壳 STL + 离线 3D 展示页 viewer.html
    - BOM/网表/引脚表 CSV; 全流程 Python 生成器工具链
    [01_power.kicad_sch, 02_mcu.kicad_sch, 03_imu_mux.kicad_sch, 04_health.kicad_sch, 05_audio.kicad_sch, 06_gnss_display.kicad_sch, bom-petvest-hub.csv, bom-petvest-imu-node.csv]
2026-11-07 chore: 标记展示资产, 修正语言统计
2026-11-08 feat: 新增 jsDelivr CDN 版 3D 展示页 (服务器部署用)
2026-11-08 docs: 添加线上 3D 展示页入口 (jsDelivr CDN 版)
2026-11-09 feat: PCB v9 布局 (76x42mm, 重叠清零) + FreeRouting 会话 + 修复工具链
    - 布局修复 17 处真实重叠 (0603/0805 竖排 2.1mm 规则, J1 旋转, SW3, J10)
    - hub_v9.ses: FreeRouting 会话 (KiCad GUI File>Import>Specctra Session 一键布线)
    - tools/repair_placement.py: DRC 自动修复循环
    [hub_v9.dsn]
2026-11-09 feat: PCB 自动布线 95% (信号网全通 + B.Cu 电源网 + 双层铺铜) + 布线渲染图
    [petvest-hub.kicad_pcb]
2026-11-09 wip: PCB 布线 + 218 过孔缝合 (DRC 中间态, 待逐项清理)
    [petvest-hub.kicad_pcb]
2026-11-09 feat: PCB 自动布线 95% (v9 信号全通 + 6/8 电源网 B.Cu BFS + 双层铺铜)
    - 剩余 10 段电源连接需 GUI 交互式布线 (密集区, 见 README 路线指南)
    - 已知良性 DRC: 官方封装内部间隙 + 0.5mm LGA 阈值告警
    [petvest-hub.kicad_pcb]
2026-11-09 feat: PCB 零短路 ✓ (95×53mm + 全信号布通 + 电源F.Cu走线 + 双层铺铜)
    - 95×53mm 板 (较 v9 加宽 25%): 消除布局重叠
    - FreeRouting 会话信号布通 (57 网)
    - 电源网 F.Cu L-route 兜底
    - GND 底层铺铜 + 3V3 顶层铺铜 + 天线禁布区
    - 剩余: GND 缝合过孔 + 零星信号 (KiCad GUI 交互完成)
    [petvest-hub.kicad_pcb]
2026-11-10 feat: PCB 完整布线 + 电源 F.Cu 路由 + GND 铺铜 (41 交叉待 GUI 修)
    [petvest-hub.kicad_pcb]
2026-11-10 revert: 恢复零短路最优态 (db33f23), 4层过孔穿平面引入短路需盲孔设计
    [petvest-hub.kicad_pcb, petvest-imu-node.kicad_pcb]
2026-11-10 fix: PCB 精修 (短路 41→5, 间距违规→0, GND 缝合 58 过孔, 剩余 5 短路待 GUI 微调)
    [petvest-hub.kicad_pcb]
